kofikofi123/ECE_2804_Audio/README.md

Fall 2023 ECE 2804 Audio Equalizer Project

by Jacob Fast and Kofi Ofosu-Tuffour
