kofikofi123/ECE_2804_Audio/Reports/FinalPresentation.pdf

# Home Audio System Project

## ECE 2804

Jacob & Kofi

# Project Goals

- Home Audio System ● 3-band Equalizer ● Class D Amplifier ● Arduino Spectrogram

## Project Overview

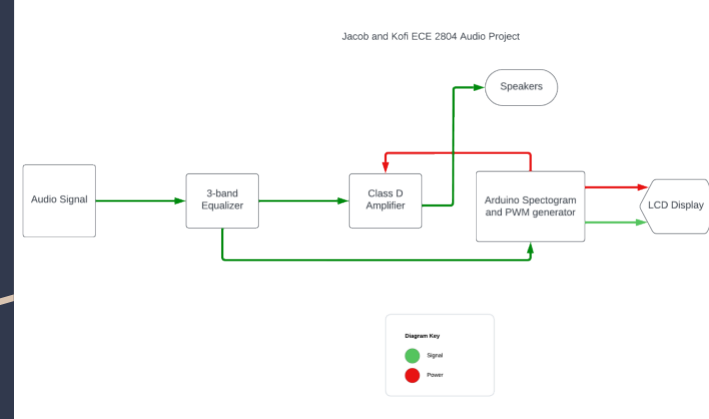
[picture p1: figure]

- 3-Band Equalizer (EQ)
- Designed, simulated, and built EQ
- Designed, simulated, and built Class D amplifier
- Arduino Spectrogram outputting to LCD Display
- Wrote pseudo code, wrote actual code, connected output to LCD Display.

# Audio Equalizer

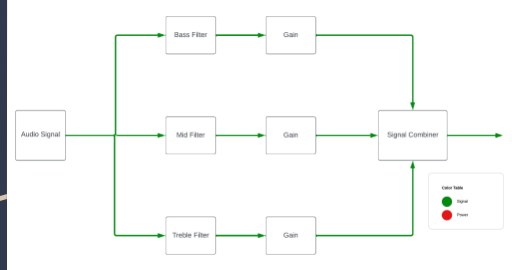
[picture p2: figure]

- Three band EQ
- - Bass
- - Mid
- - Treble
- Variable gain for each individual band
- Bands get recombined to form output signal

# Graphic Equalizer

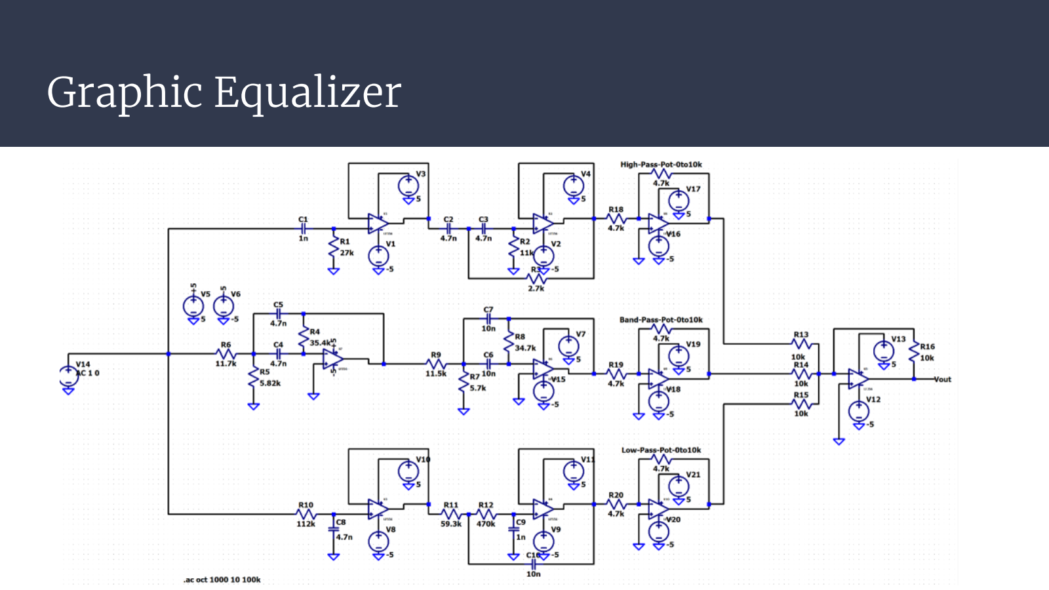
[picture p3: page 5]

# Bass Filter

- Chose cutoff frequency
- Design Filter using Analog Filter Wizard
- Derived Equation

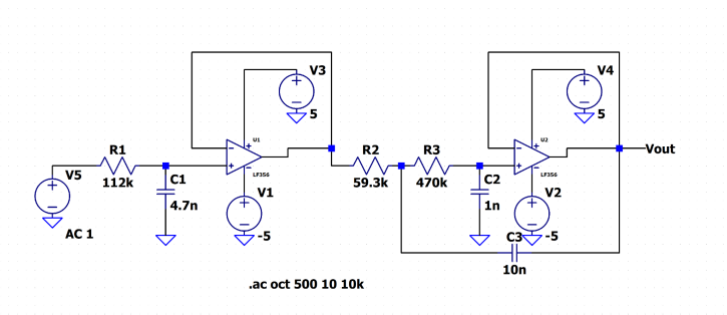
[picture p4: figure]

Bass Filter cont.

- Simulation of frequency response
- Measured frequency response
- Measured response closely matches simulated response

# Bass Filter Simulated Results

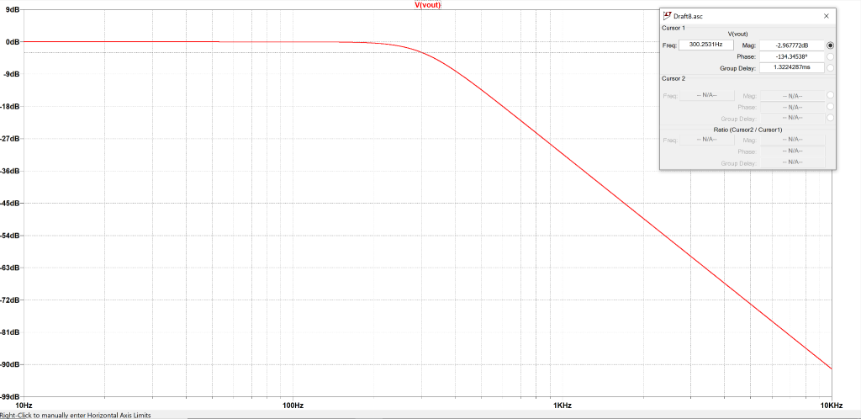
[picture p5: page 8]

# Bass Filter Validated Results

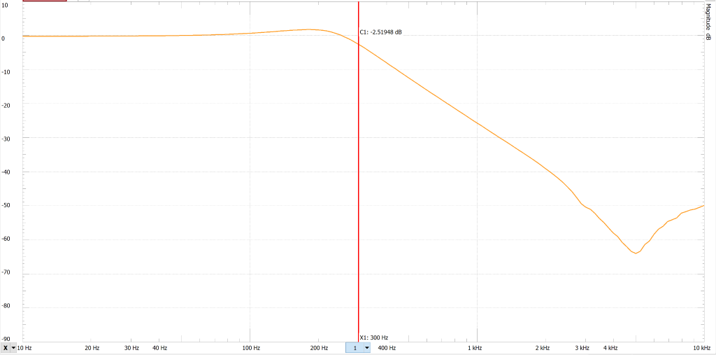
[picture p6: page 9]

# Mid Filter

- Repeated process we used to develop bass filter
- Chose cutoff frequency
- Design Filter using Analog Filter Wizard
- Derived Equation

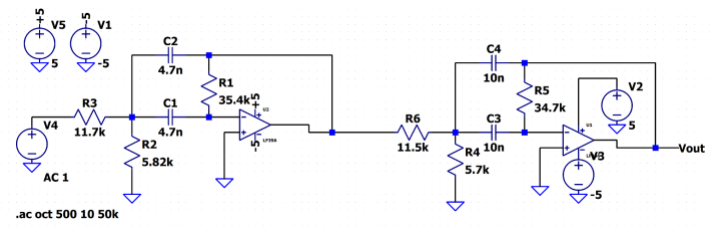
[picture p7: figure]

Mid Filter cont.

- Simulation of frequency response
- Measured frequency response
- Measured response closely matches simulated response

# Mid Filter Simulated Frequency Response

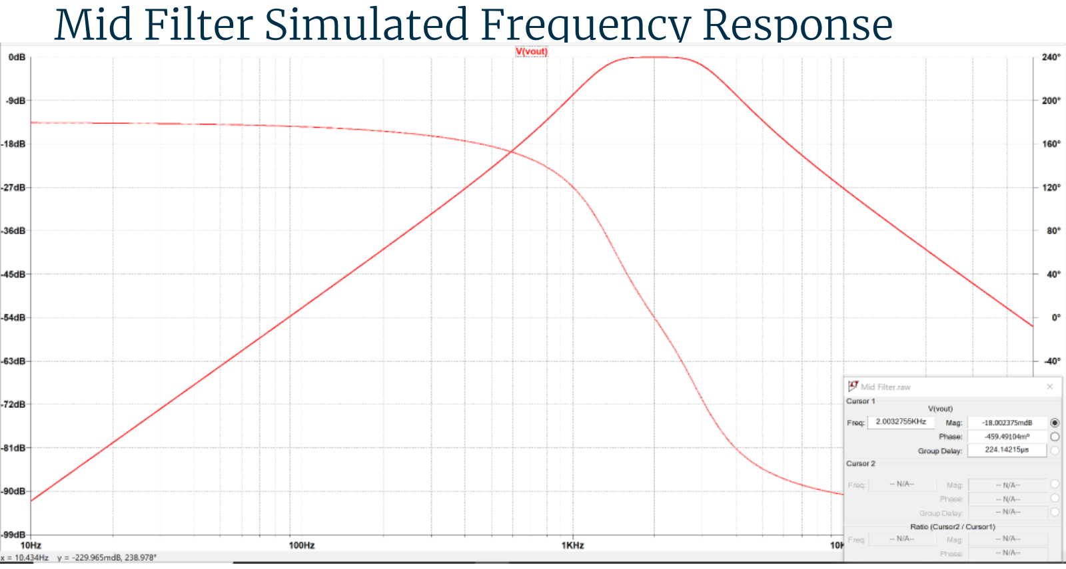
[picture p8: page 12]

# Mid Filter Measured Frequency Response

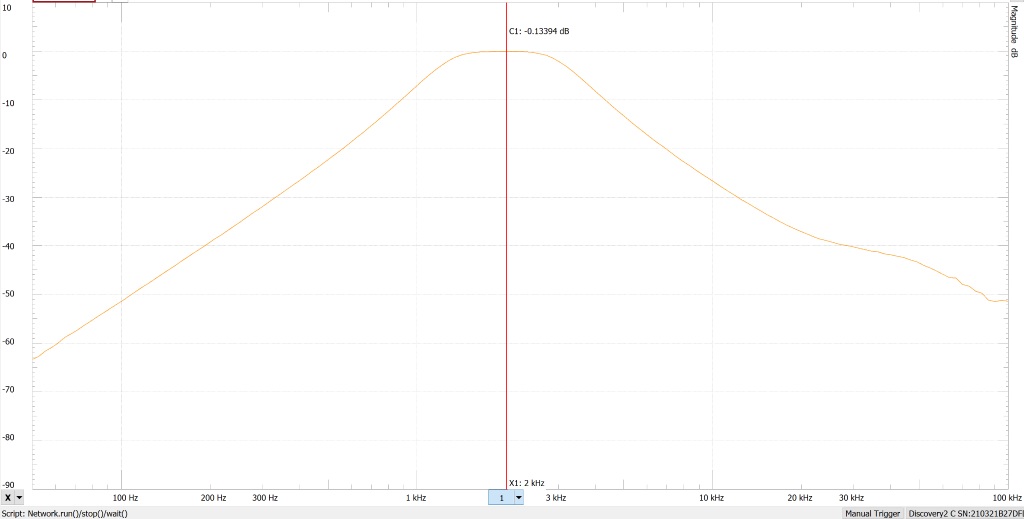
[picture p9: page 13]

# Treble Filter

- Repeated process we used to develop other filters
- Chose cutoff frequency
- Design Filter using Analog Filter Wizard
- Derived Equation

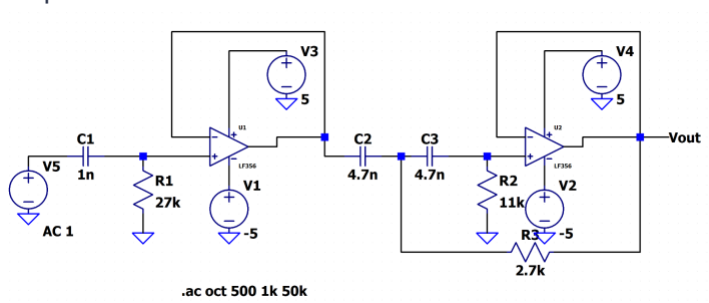
[picture p10: figure]

Treble Filter cont.

- Simulation of frequency response
- Measured frequency response
- Measured response closely matches simulated response

# Treble Filter Simulated Results

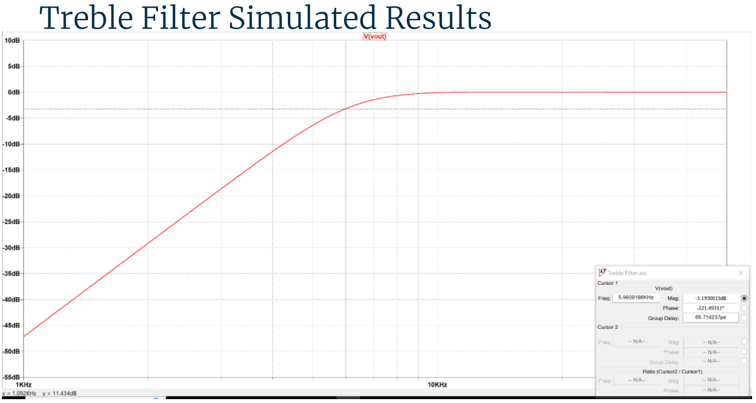
[picture p11: page 16]

# Treble Filter Validated Results

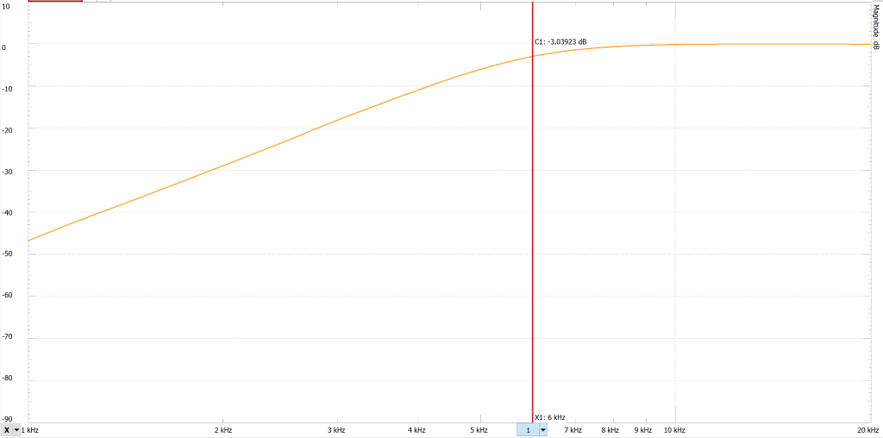
[picture p12: page 17]

# Variable Gain

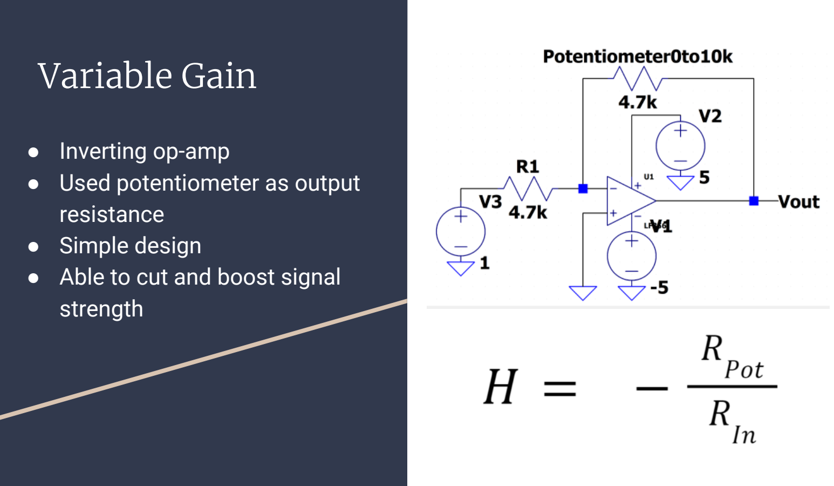
[picture p13: page 18]

- Inverting op-amp
- Used potentiometer as output resistance
- Simple design
- Able to cut and boost signal strength

# Summing Amplifier

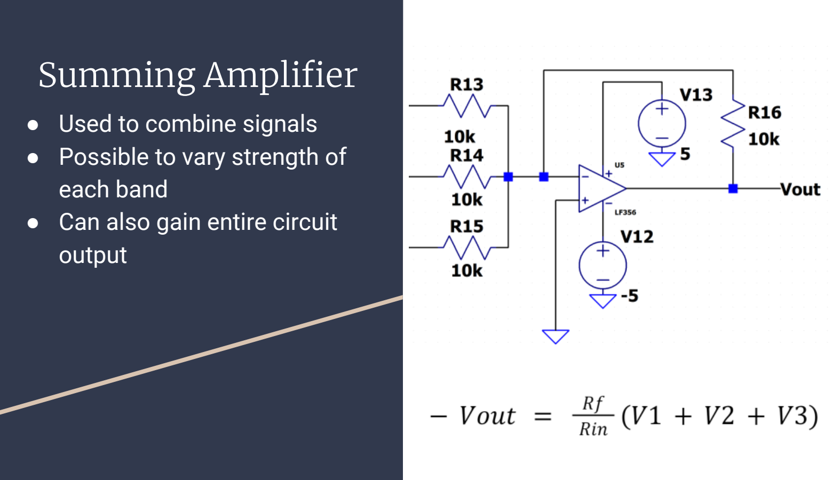
[picture p14: page 19]

- Used to combine signals
- Possible to vary strength of each band
- Can also gain entire circuit output

# Variable Gain- LTspice neutral position

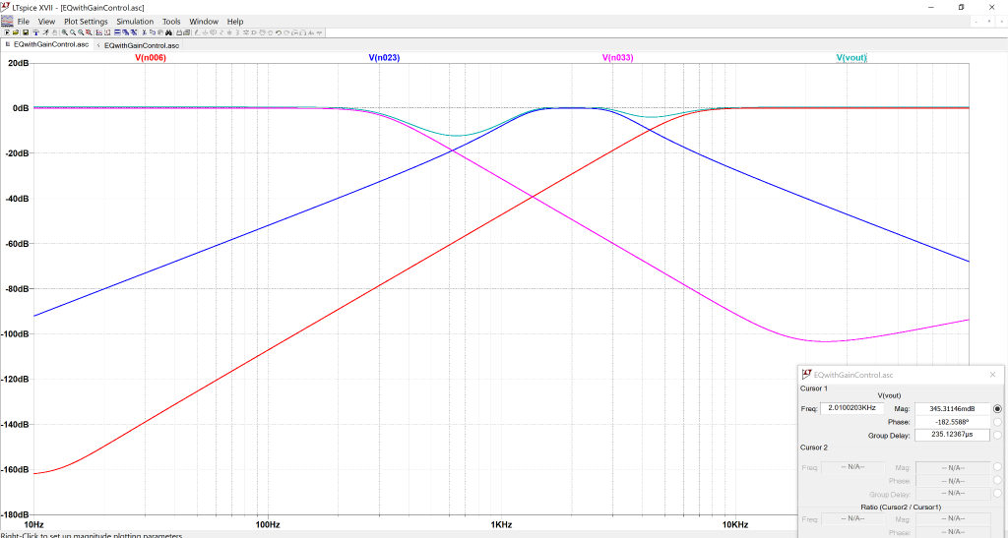
[picture p15: page 20]

## Variable Gain- Waveform neutral position

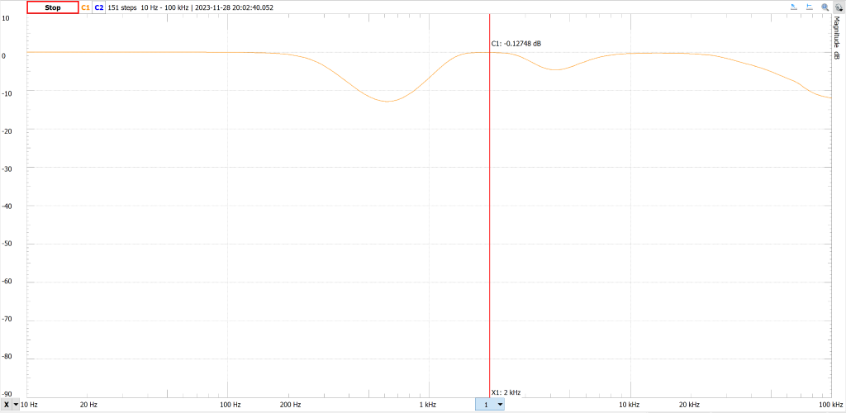
[picture p16: page 21]

## Variable Gain- LTspice max position

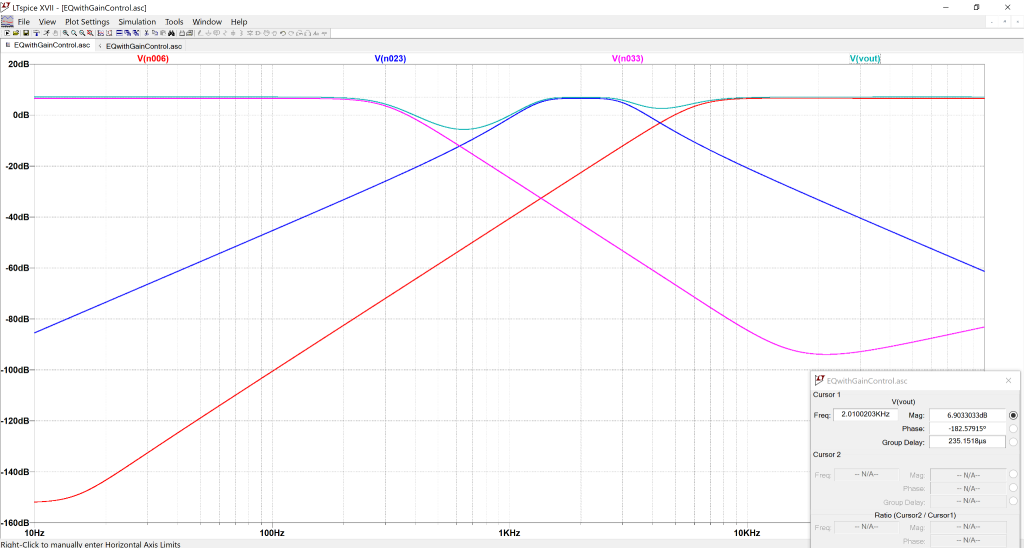
[picture p17: page 22]

## Variable Gain- Waveform max position

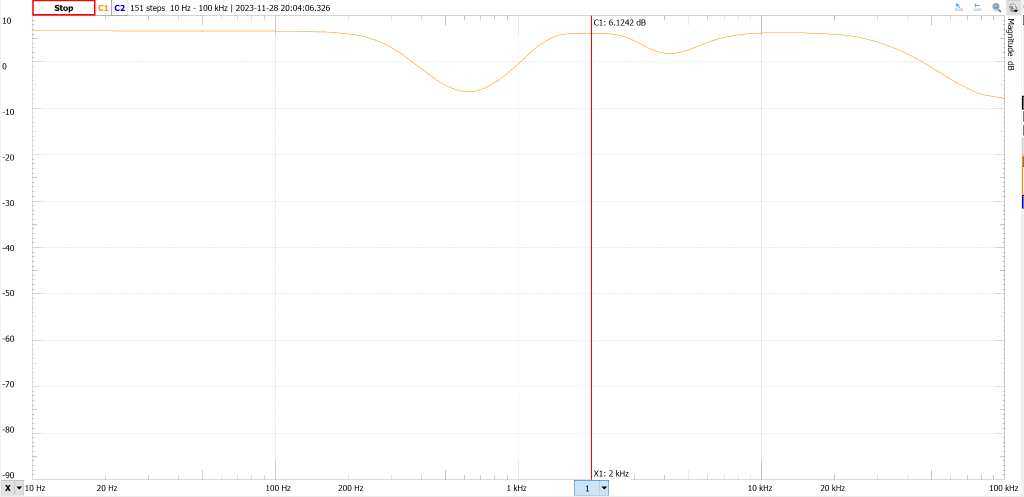
[picture p18: page 23]

## Variable Gain- LTspice min position

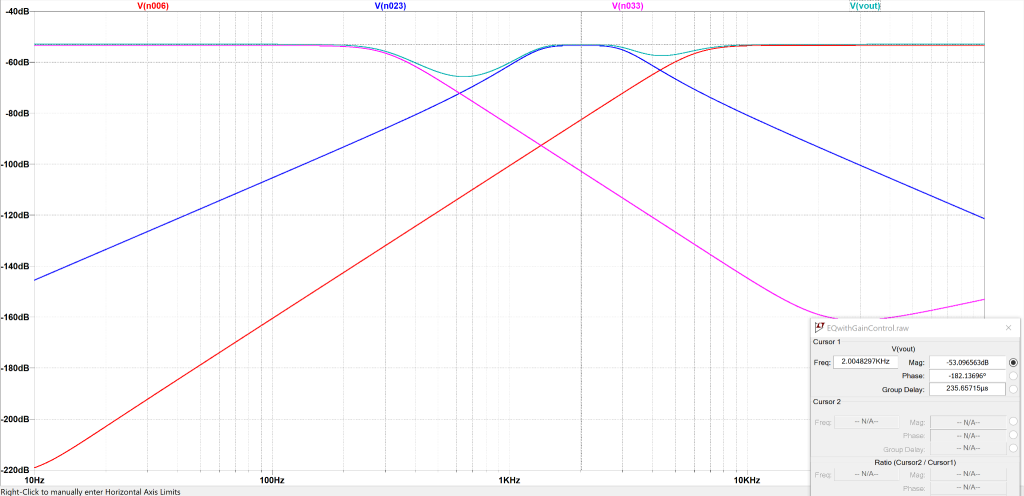
[picture p19: page 24]

## Variable Gain- Waveform min position

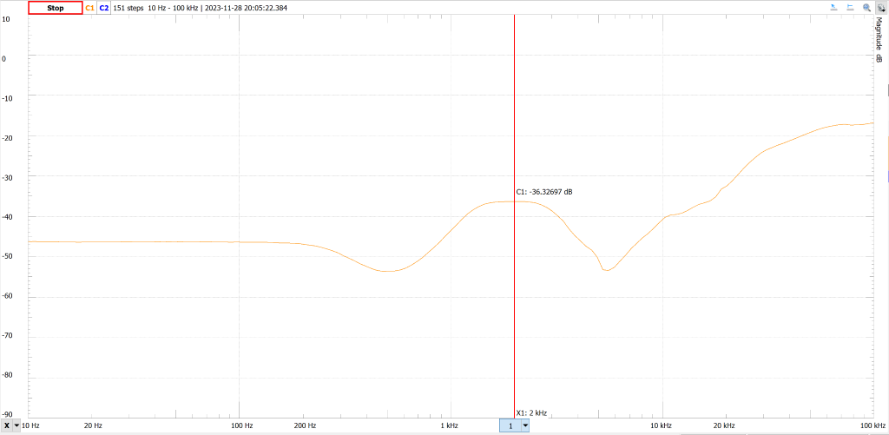
[picture p20: page 25]

# Class D Amplifier

- What is Class D Amplifier? ● Why Class D? ○ Power Efficiency!! ● Half-Bridge design ● Dedicated modulation from 555 Timer ● Goal: 5V peak-to-peak voltage

# Class D Amplifier

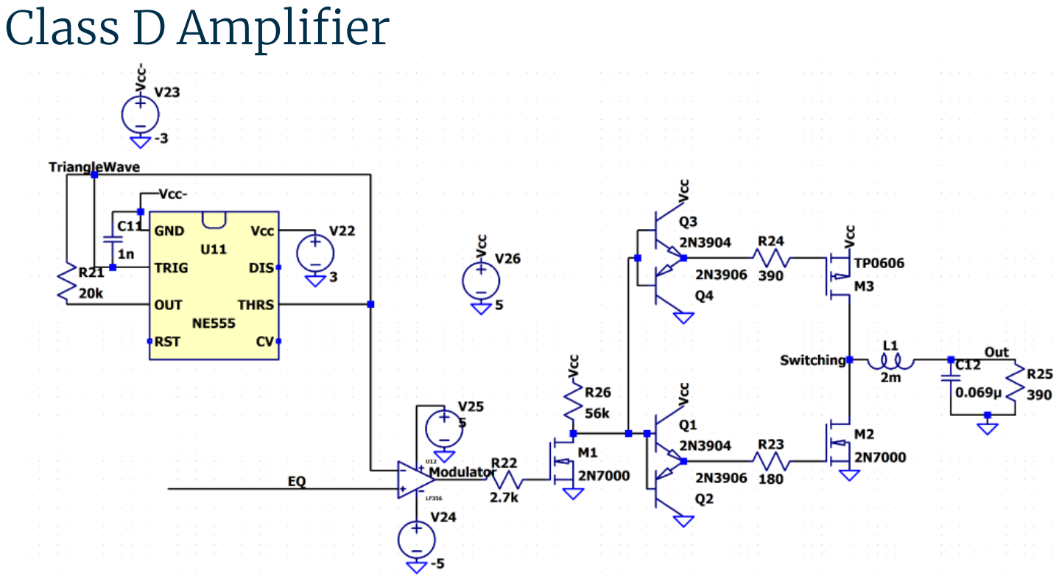
[picture p21: page 27]

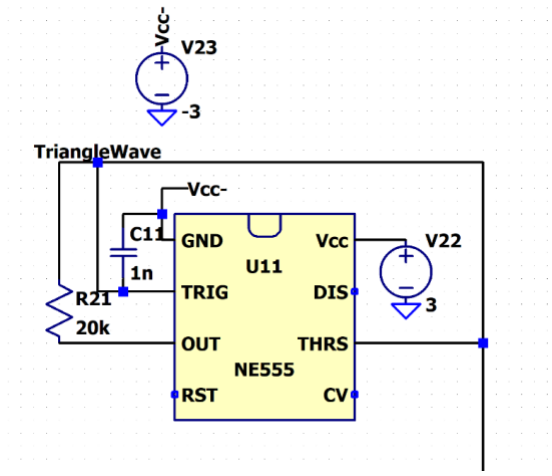
[picture p22: figure]

# Triangle Generation

- Triangle Generation from 555 timer
- Based on charging and
discharging of capacitor
- No need for extra integrator circuit
- Capable of generating 200 kHz triangle wave
- For this project we brought it down to 50 kHz

# Modulator

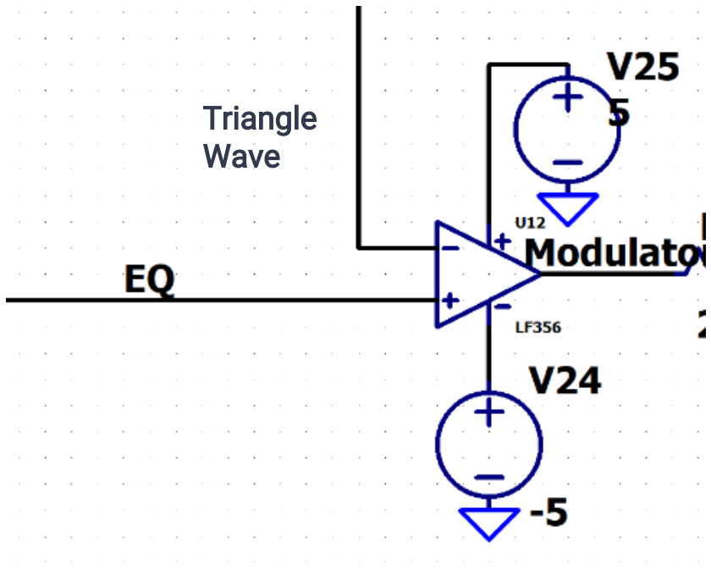
[picture p23: figure]
Triangle Wave

- LF356 op-amp as comparator
- Compares audio signal with triangle wave to produce
PWM

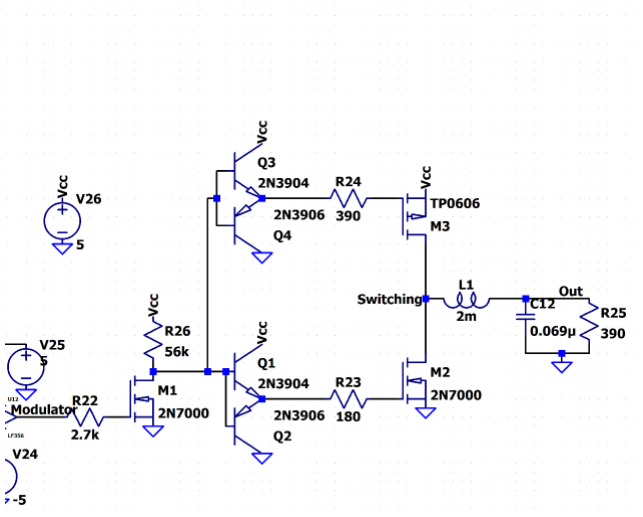
[picture p24: figure]

# Class D Amplification

- PWM signal is sent from the modulator to a gate driver.
- Why a gate driver?
- CMOS output stage
configuration

# Filter stage

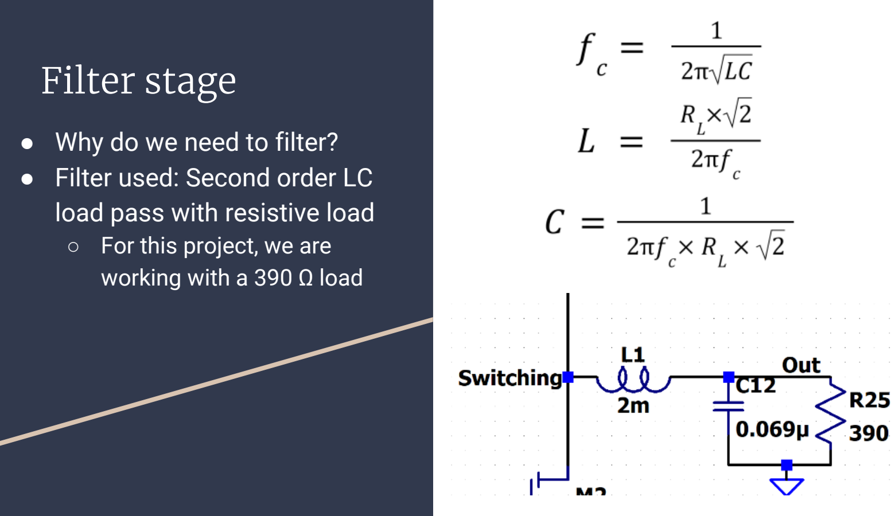
[picture p25: page 31]

- Why do we need to filter?
- Filter used: Second order LC load pass with resistive load
- For this project, we are working with a 390 Ω load

# Simulated Results

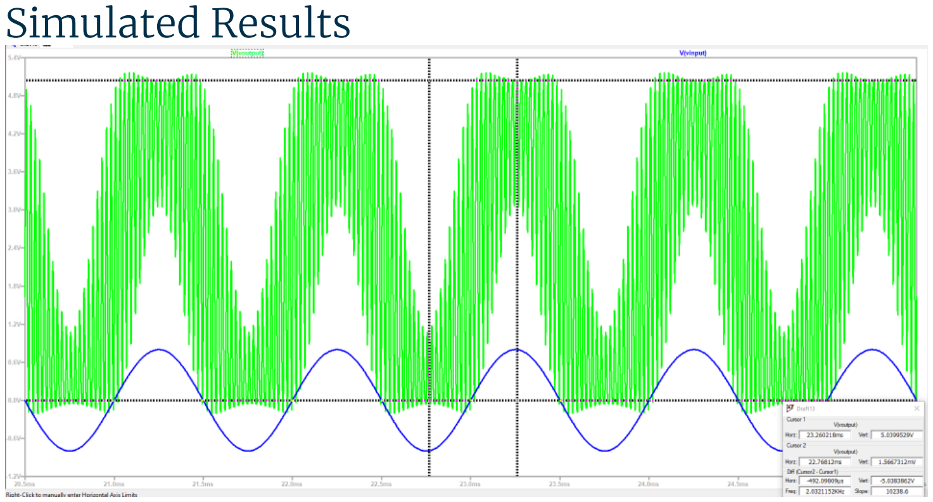
[picture p26: page 32]

# Validated Results

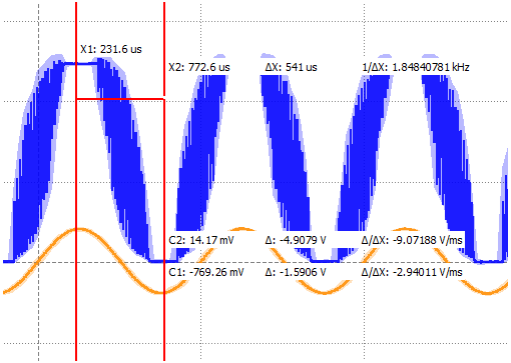
[picture p27: figure]

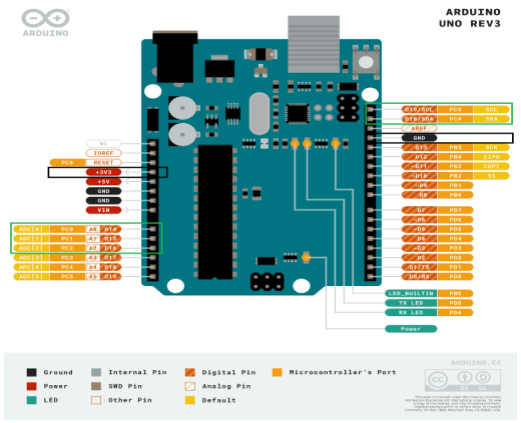
[picture p28: figure]

# User Interface

- Arduino with 128x64 LCD
screen (I2C)
- 1 pins reserved for
spectrogram
- 3.3V power and ground for LCD

# User Interface

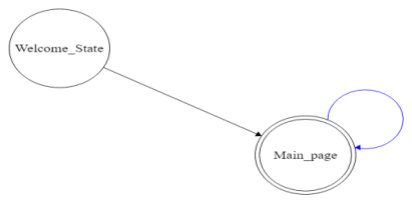
[picture p29: figure]

### - Two important states

- Welcome state
- Main page state

# User Interface - Setup

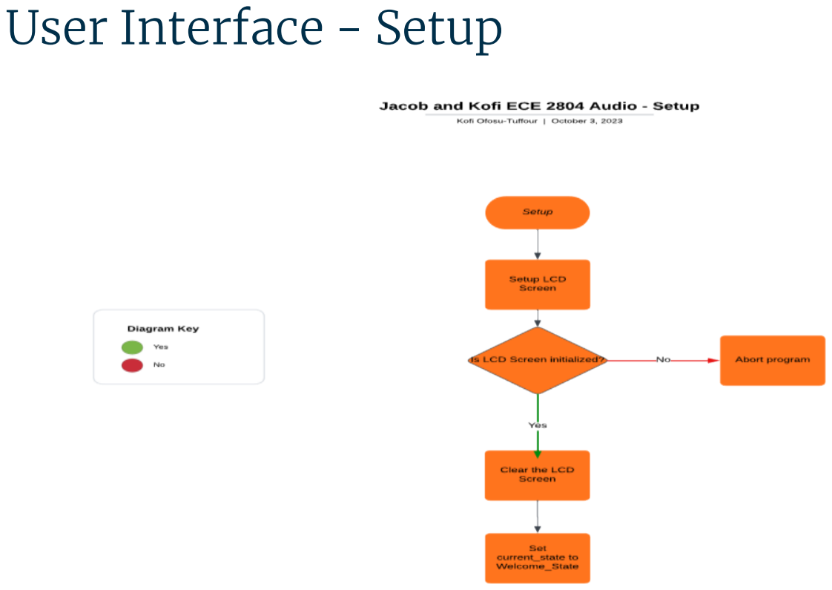
[picture p30: page 36]

# User Interface - Loop

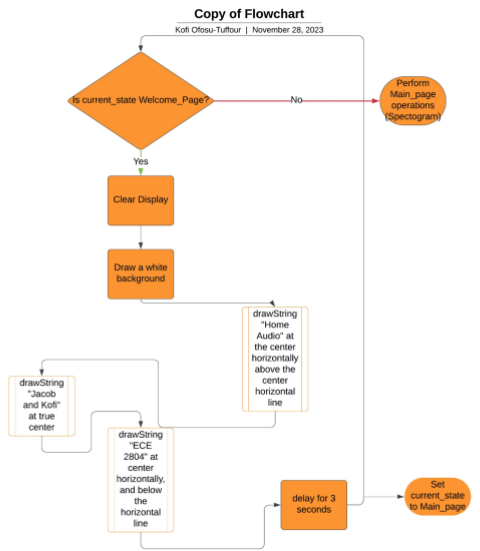
[picture p31: figure]

# User Interface - Loop

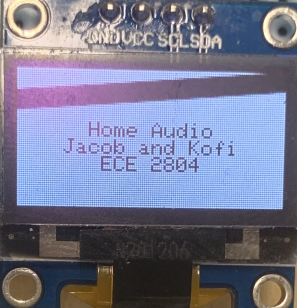
[picture p32: figure]

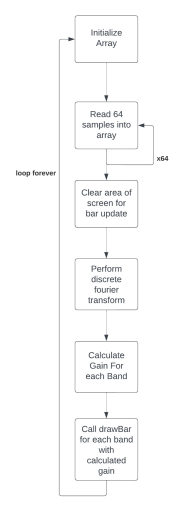
[picture p33: figure]

# Spectrogram

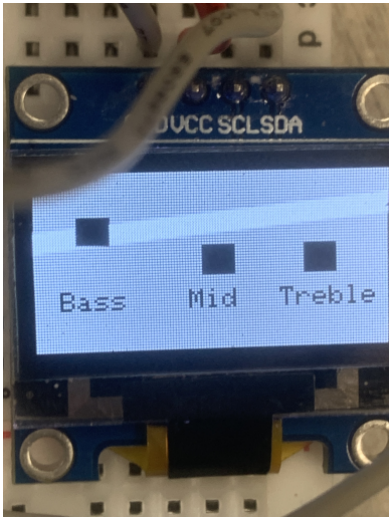
[picture p34: figure]

# Bass Testing -Max Gain

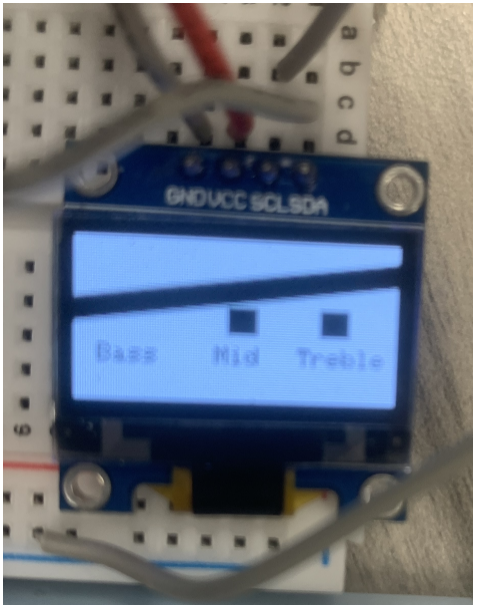
[picture p35: figure]

# Bass Testing -No Gain

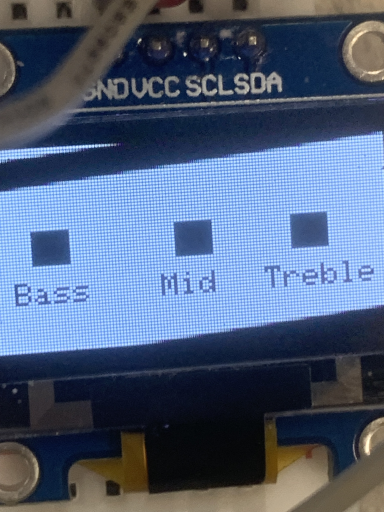
[picture p36: figure]

# Bass Testing -Attenuated Gain

# Questions?
